NihatMuradli/WRO2025-FE-VillageBoys/Vehicle-Schemes/README.md

Electromechanical diagrams
====

This directory contains the **electrical diagrams and schematics** of the Hoqqa project. It includes three key files:

1. **First Task Algorithm Map** – outlining the logic flow for the initial challenge.
2. **Second Task Algorithm Map** – detailing the decision-making process for the second challenge.
3. **Electrical Wiring Diagram** – showing the complete wiring and connections of the Hoqqa robot.
