NihatMuradli/WRO2025-FE-VillageBoys/assets/README.md

All visual materials, including photos and diagrams, are provided solely for the purpose of explaining the project concept. These images are copyrighted and owned by the **Village Boys Team.**
