NihatMuradli/WRO2025-FE-VillageBoys/Team-Photos/Fun-Photo.jpg

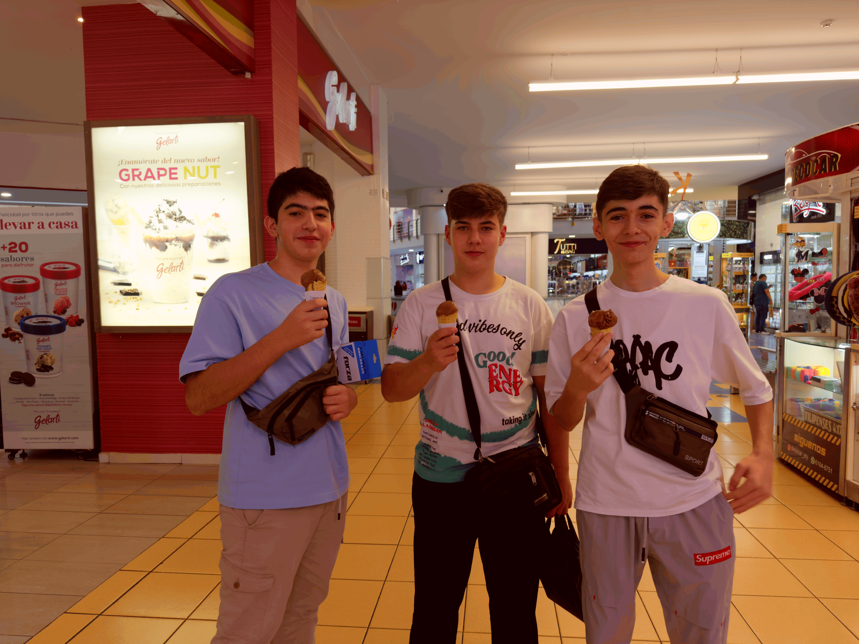
Team-Photos/Fun-Photo.jpg
