NihatMuradli/WRO2025-FE-VillageBoys/Team-Photos/Official-Photo.jpeg

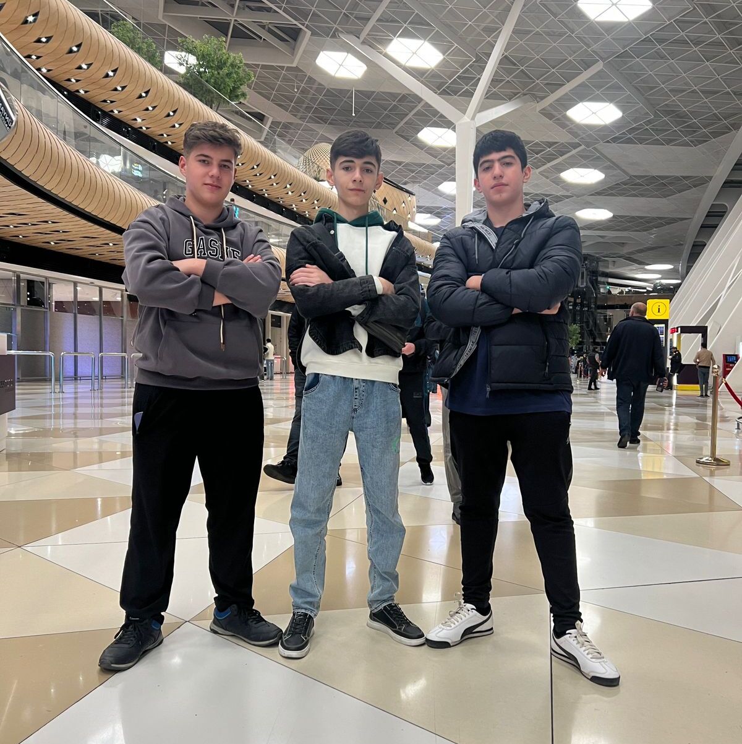
Team-Photos/Official-Photo.jpeg
