NihatMuradli/WRO2025-FE-VillageBoys/Vehicle-Photos/back.jpeg

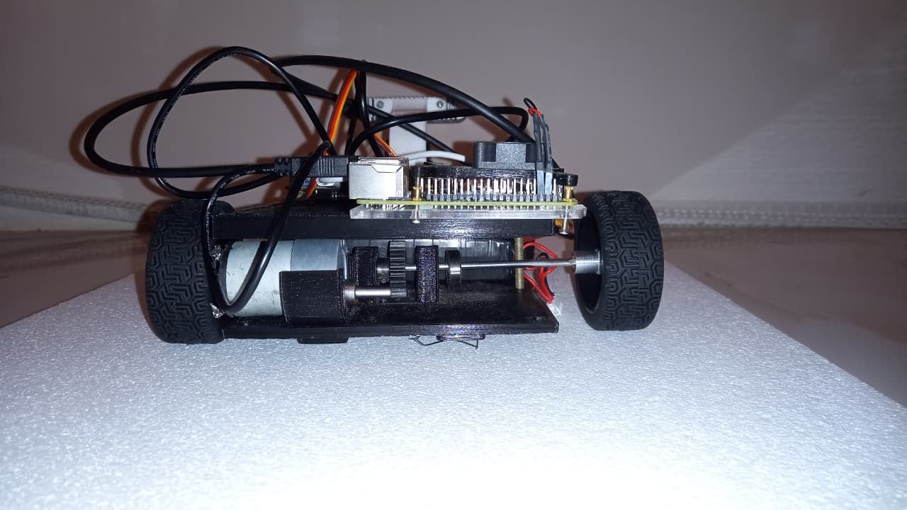
Vehicle-Photos/back.jpeg
