NihatMuradli/WRO2025-FE-VillageBoys/Vehicle-Photos/bottom.jpeg

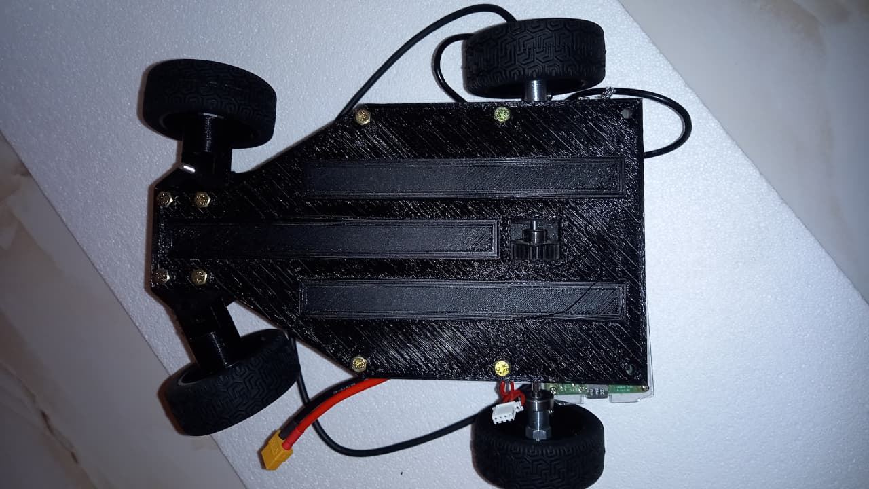
Vehicle-Photos/bottom.jpeg
