NihatMuradli/WRO2025-FE-VillageBoys/Vehicle-Photos/front.jpeg

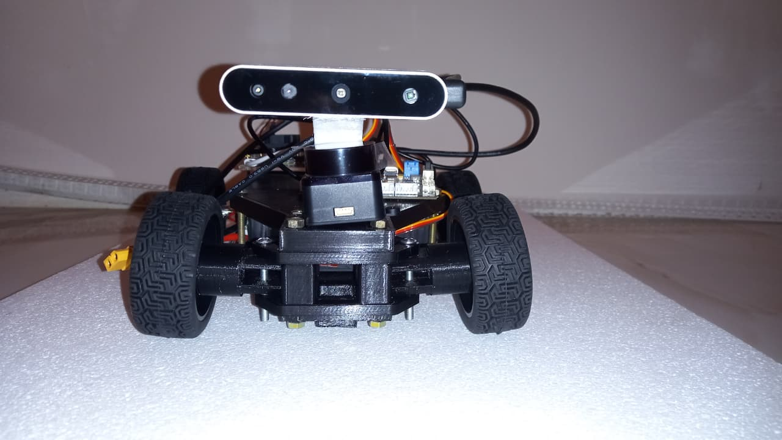
Vehicle-Photos/front.jpeg
