NihatMuradli/WRO2025-FE-VillageBoys/Vehicle-Photos/left.jpeg

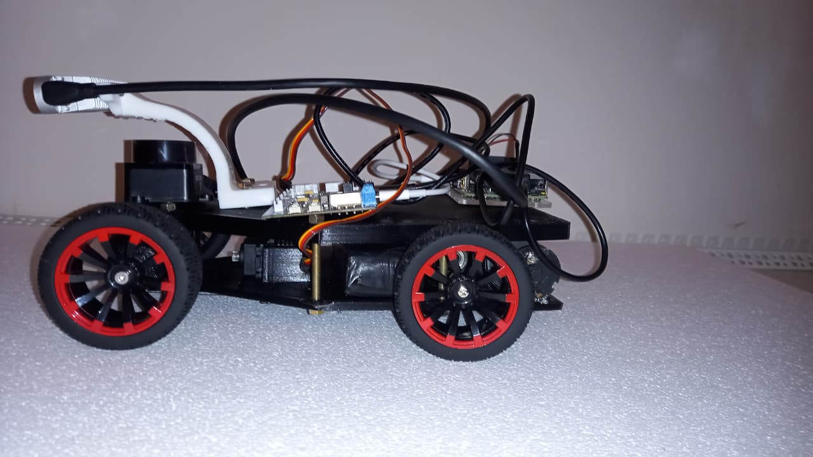
Vehicle-Photos/left.jpeg
