NihatMuradli/WRO2025-FE-VillageBoys/Vehicle-Photos/right.jpeg

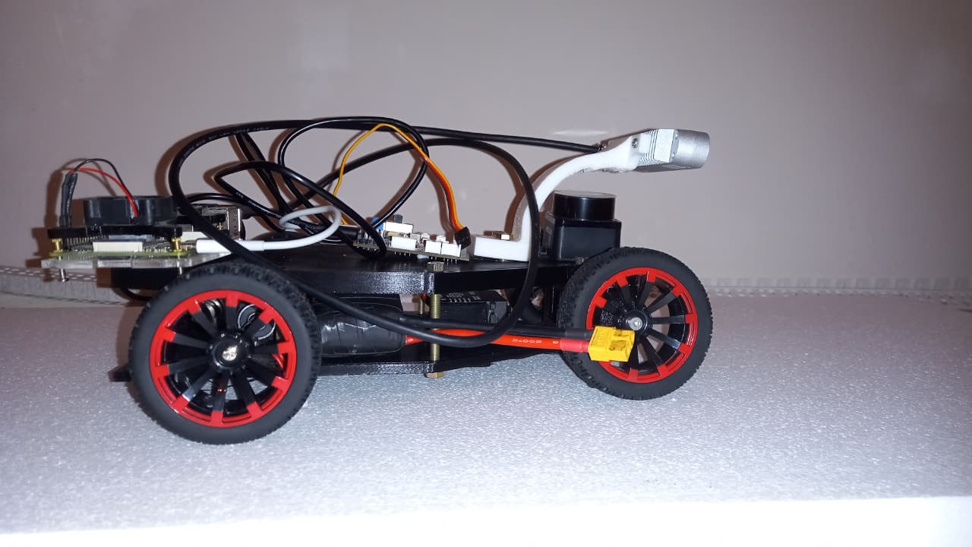
Vehicle-Photos/right.jpeg
