NihatMuradli/WRO2025-FE-VillageBoys/Vehicle-Photos/top.jpeg

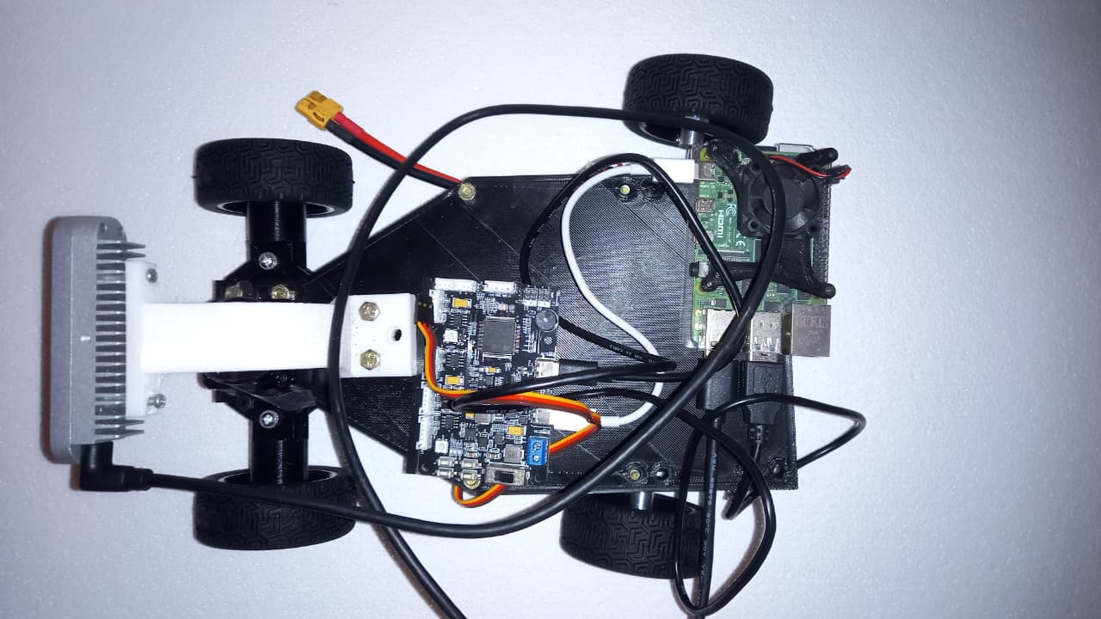
Vehicle-Photos/top.jpeg
