NihatMuradli/WRO2025-FE-VillageBoys/List-of-Materials/README.md

| Name | Quantity | Price | Images |
|---|---|---|---|
| Nuwa HP60C Depth Camera | 1 | $104.99 | Nuwa HP60C |
| LDROBOT D500 lidar kit  | 1 | $69 | LDROBOT D500 |
| DC MOTOR 12V | 1 | $5.31 | DC MOTOR |
| Wheels (4x) | 1 | $9.99 | Wheels |
| IMU Controller | 1 | $39.99  | IMU Controller |
| Gear 26T | 2 | $5.48 | Gear 26T |
| Steel Rods (5x) | 1 | $3.76 | Steel Rods |
| 40 KG SERVO MOTOR | 1 | $25 | SERVO MOTOR |
