NihatMuradli/WRO2025-FE-VillageBoys/List-of-Materials/Hoqqa spreadsheet - Sheet1.pdf

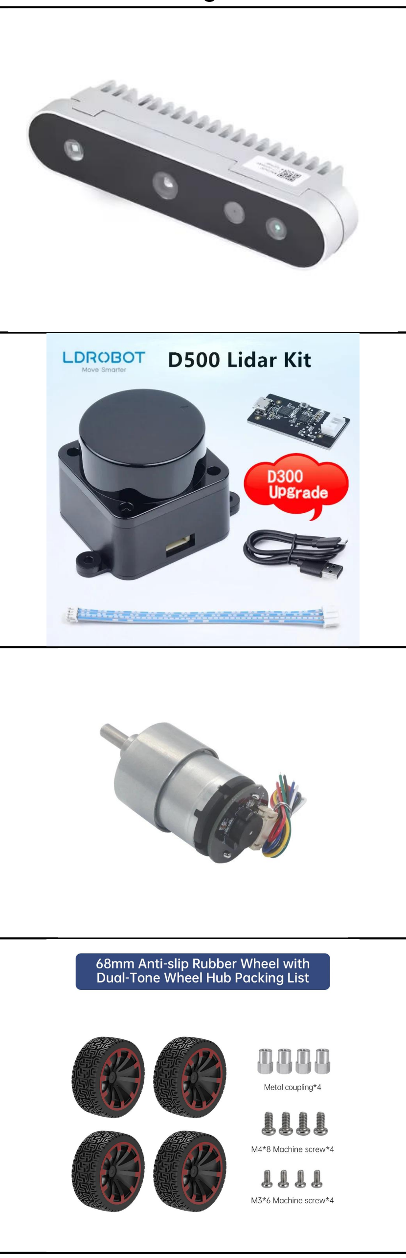
[picture p21: figure]

Name | Quantity | Price | Images
Nuwa HP60C Depth Camera (https://www.alibaba.com/product-detail/Nuwa-HP60C-Depth-Camera-Binocular-Structured_1601463158510.html) | 1 | $104.99
LDROBOT D500 lidar kit (https://m.aliexpress.ru/item/0_1005003012681021.html?sku_id=12000042409784258) | 1 | $69
DC MOTOR 12V (https://aliexpress.ru/item/1005008860176259.html?sku_id=12000046982413743) | 1 | $5.31
Wheels (4x) (https://www.hiwonder.com/products/mecanum-omnidirectional-wheel-metal-coupling-motor-ros-robot-universal-wheel-smart-car-tire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) | 1 | $9.99

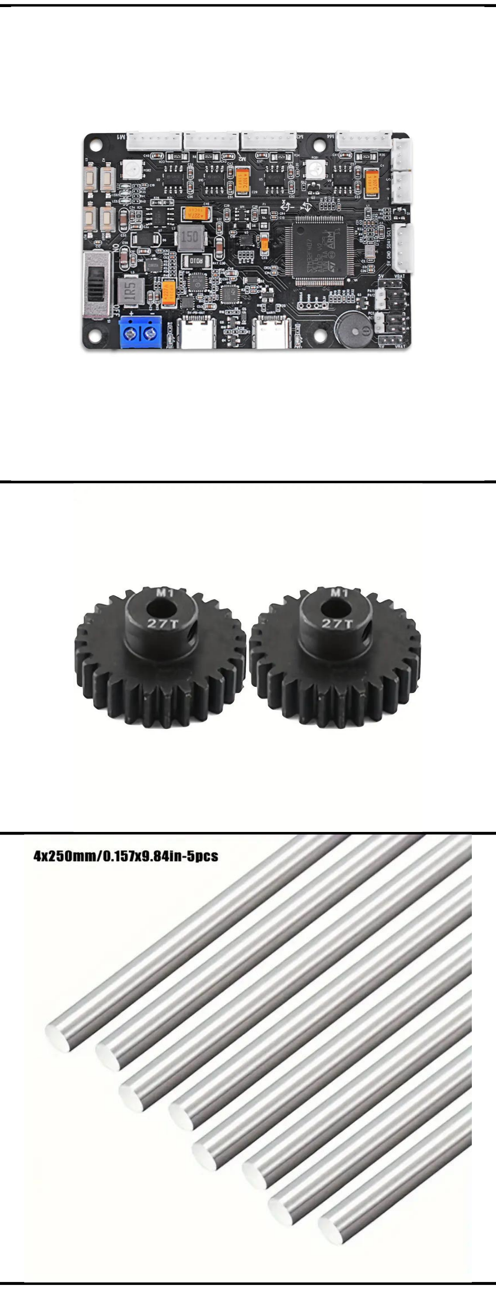
[picture p22: figure]

IMU Controller (https://www.hiwonder.com/products/rrc-lite?_pos=1&_sid=3dee0c85b&_ss=r) | 1 | $39.99
Gear 26T (https://www.temu.com/goods.html?_bg_fs=1&goods_id=601100555090307&sku_id=17596359138685&_x_sessn_id=1bsu0oki76) | 2 | $5.48
Steel Rods (5x) (https://www.temu.com/goods.html?_bg_fs=1&goods_id=601099575827375&sku_id=17592448432361&_x_sessn_id=1bsu0oki76) | 1 | $3.76
