NihatMuradli/WRO2025-FE-VillageBoys/Vehicle-Models/Moving-axe.stl

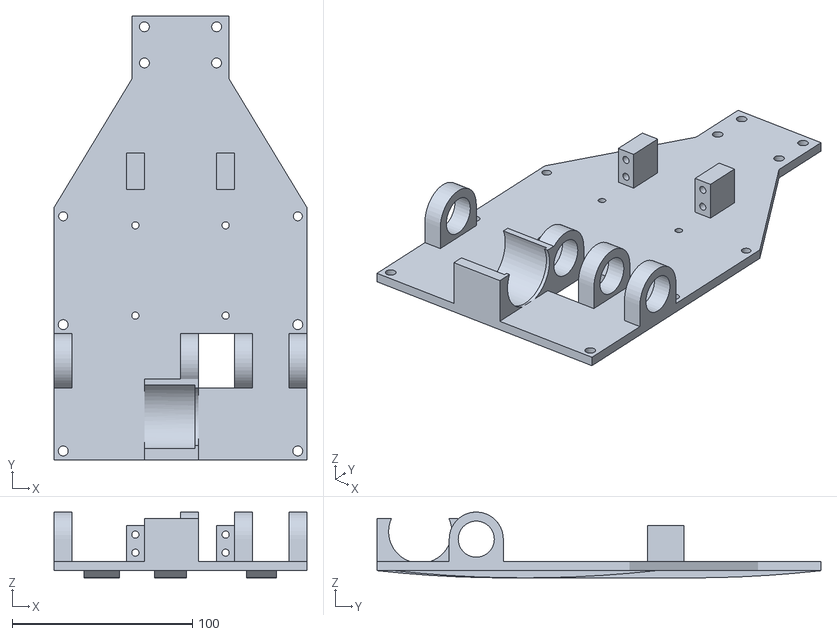
[picture p23: CAD file, 2025-09-10]
Vehicle-Models/Moving-axe.stl
140.0 x 246.0 x 36.5
