NihatMuradli/WRO2025-FE-VillageBoys/Vehicle-Models/Bricks-3.stl

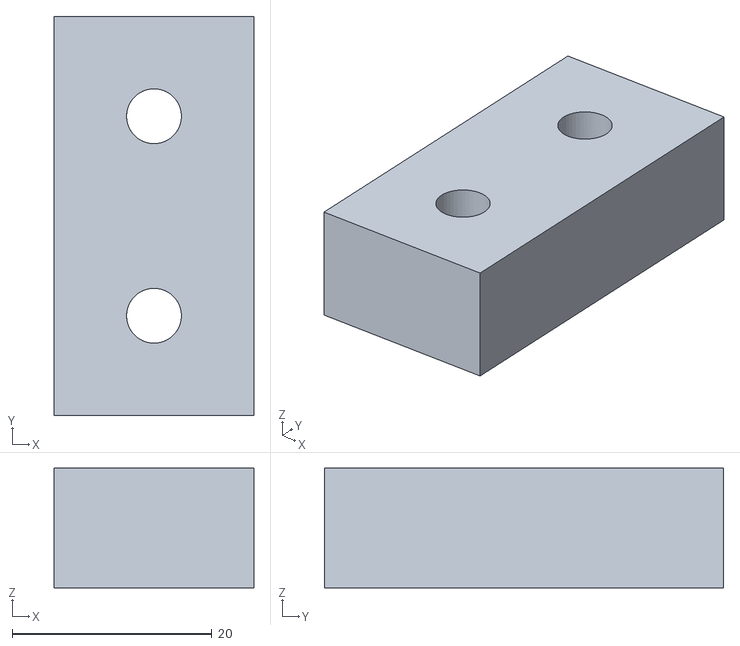
[picture p24: CAD file, 2025-09-10]
Vehicle-Models/Bricks-3.stl
20.0 x 40.0 x 12.0
