NihatMuradli/WRO2025-FE-VillageBoys/Vehicle-Models/Column.stl

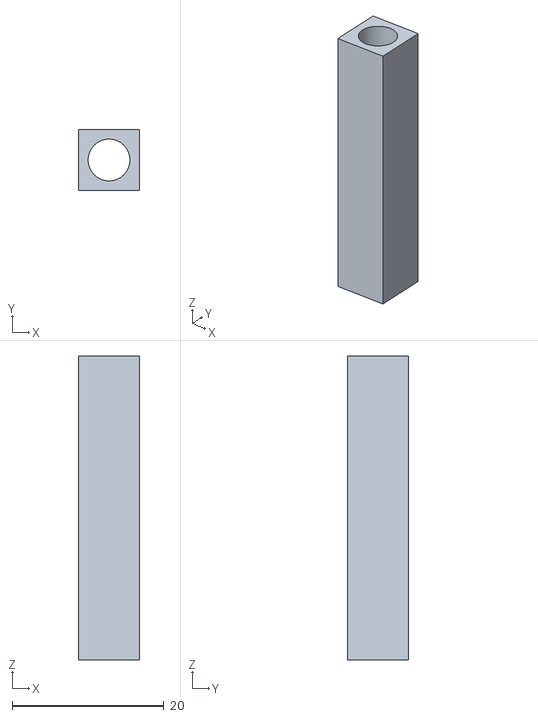
[picture p25: CAD file, 2025-09-10]
Vehicle-Models/Column.stl
8.00 x 8.00 x 40.0
