NihatMuradli/WRO2025-FE-VillageBoys/Vehicle-Models/Wheel-Catcher.stl

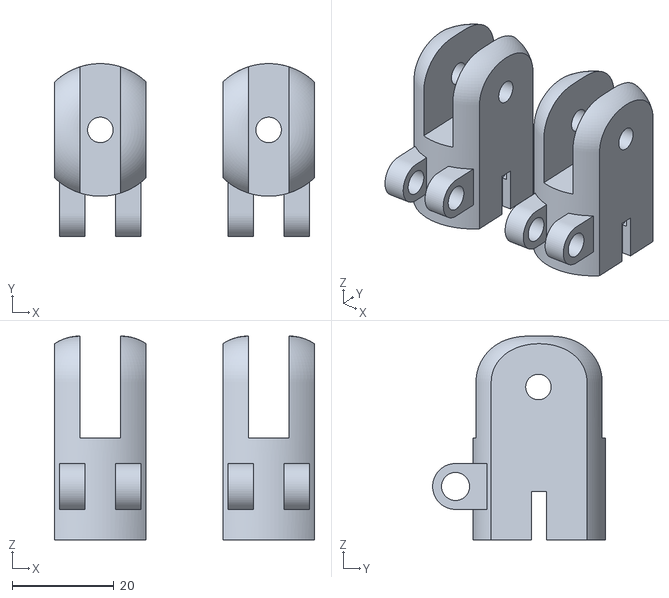
[picture p26: CAD file, 2025-09-10]
Vehicle-Models/Wheel-Catcher.stl
51.0 x 33.9 x 40.0
