NihatMuradli/WRO2025-FE-VillageBoys/Vehicle-Models/Second-floor.stl

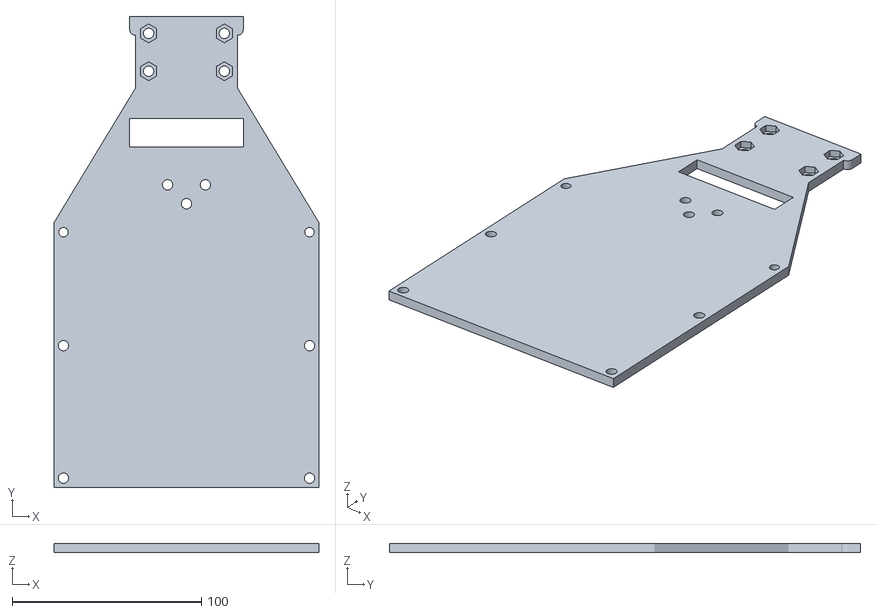
[picture p27: CAD file, 2025-09-10]
Vehicle-Models/Second-floor.stl
140.0 x 249.0 x 5.00
