NihatMuradli/WRO2025-FE-VillageBoys/Vehicle-Models/Front-Wheel-Brick.stl

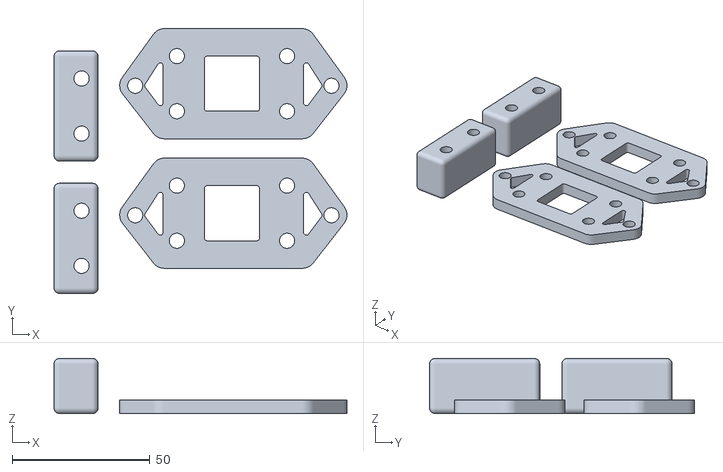
[picture p28: CAD file, 2025-09-10]
Vehicle-Models/Front-Wheel-Brick.stl
106.3 x 96.1 x 20.0
