NihatMuradli/WRO2025-FE-VillageBoys/Vehicle-Models/camera-holder.stl

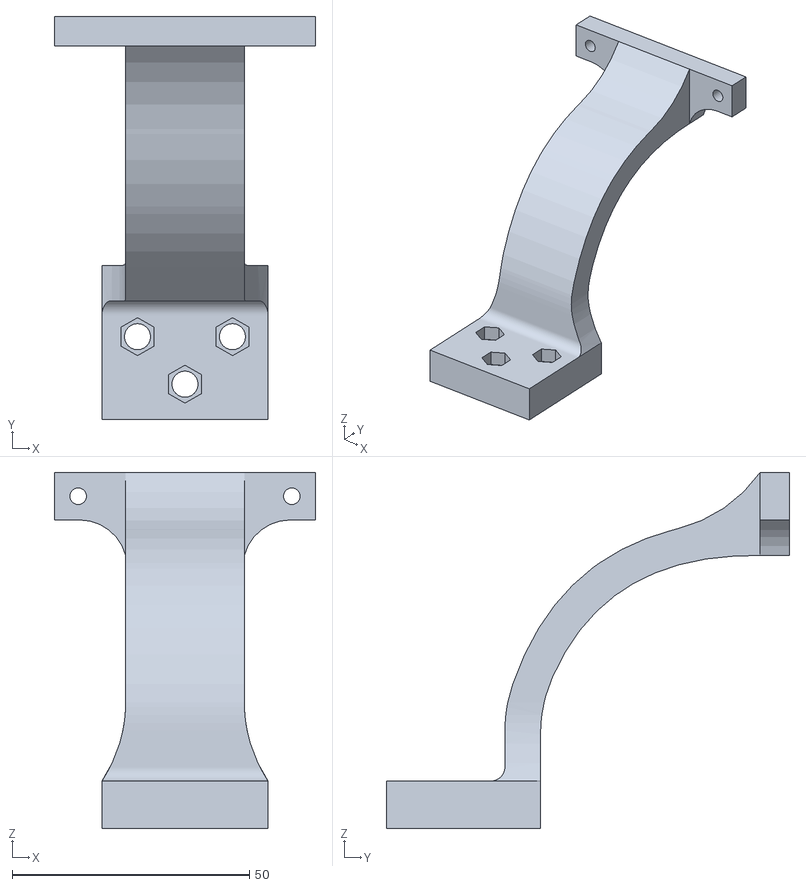
[picture p29: CAD file, 2025-09-10]
Vehicle-Models/camera-holder.stl
55.0 x 85.0 x 75.0
