NihatMuradli/WRO2025-FE-VillageBoys/Vehicle-Models/Bricks-2.stl

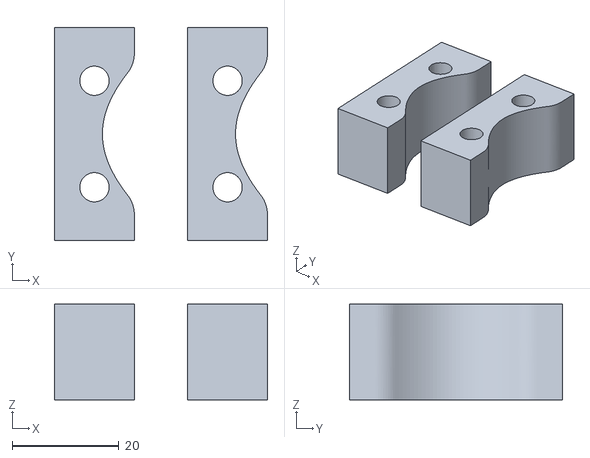
[picture p30: CAD file, 2025-09-10]
Vehicle-Models/Bricks-2.stl
40.0 x 40.0 x 18.0
