NihatMuradli/WRO2025-FE-VillageBoys/(commit log)

2025-08-03 Create List-of-Materials
2025-09-05 Servo motor added
2025-09-10 Power and sense management
2025-09-10 lidar img updated
2025-09-10 3D-Model Update-v1
    [Bricks-2.stl, Bricks-3.stl, Column.stl, Front-Wheel-Brick.stl, Moving-axe.stl, Second-floor.stl, Wheel-Catcher.stl, camera-holder.stl]
2025-09-10 Update-13v README.md
2025-09-10 PID Update-v1
